bastian-bou/PFE-roule-ma-poule-sans-nid-de-poule/README.md

# PFE Roule ma poule

Pour avoir des informations, allez dans **docs**, pour le code source c'est **dev** et pour les schémas et la carte finale c'est **Hardware**
