bastian-bou/PFE-roule-ma-poule-sans-nid-de-poule/docs/README.md

# PFE Roule ma poule

Si tu es développeur, vas voir le dossier développement et lis le fichier mainteneur.pdf pour quelques informations supplémentaires sur la communication.

Si tu es électronicien, vas voir le dossier développement.

Si tu es mainteneur, vas voir le fichier mainteneur.pdf

Le projet s'est arrêté à un prototype donc un utilisateur n'existe pas encore. l'utilisateur se nomme mainteneur et des développements restent à faire.

Pour les datasheets des composants, c'est dans *datasheet*

Pour les commandes effectuées, c'est dans le dossier *Achats* (GPS, ESP32, capteurs, batteries ...)

Pour les résultats des tests du prototype, cest dans le dossier *datas*

## Sinon voici la description de tous les livrables : 

— **Cahier des charges** : Ce premier document détaille tous les besoins du client, de façon
simplifiée et synthétique. J’ai participé à l’élaboration de ce document. J’ai apporté
des idées et des pistes techniques. Je l’ai ensuite élaboré avec l’approbation de Nicolas
Monmarche.

— **Cahier de spécifications** : Ce document est fourni avant la réalisation technique.
Je décris ma prise de recul sur le projet, l’étude du cahier des charges, les détails
techniques du projet global, des capteurs à l’application mobile de l’utilisateur. Je
décris également les deux livrables attendus par le client. Je détail les différentes
technologies de capteur de vibration qui peuvent être utilisées, les blocs fonctionnels
nécessaires dans le boîtier, l’interaction entre le boîtier, l’application mobile et le
serveur. Il y a également des diagrammes présentant les programmes et un exemple
de design du boîtier avec des voyant, la prise de recharge ainsi que le bouton ON/OFF.

— **Cahier d’analyse** : Ce document décrit toutes les parties d’études théoriques et pra-
tiques sur le projet. Concernant la partie électronique, différents montages d’interfa-
çage des capteurs sont décrits ainsi que des études logicielles concernant les librairies
et la classe principale.

— **Documentation Conception logicielle** : Ce document présente tous les détails tech-
niques sur le logiciel que j’ai développé pendant mon PFE. Des diagrammes de classes,
des logigrammes, ainsi qu’une description détaillée du code source seront présents
dans ce document. Des détails concernant la suite du projet est également disponible
dans ce document. Vous trouverez également le lien GitLab pour accéder au code
source.

— **Documentation Conception matérielle** : Cette documentation décrit les différents
éléments électroniques choisis, toutes les caractéristiques qui les définissent et mon
choix de capteur pour la surveillance des failles dans la route.
