bastian-bou/PFE-roule-ma-poule-sans-nid-de-poule/docs/cahier de spécifications.pdf

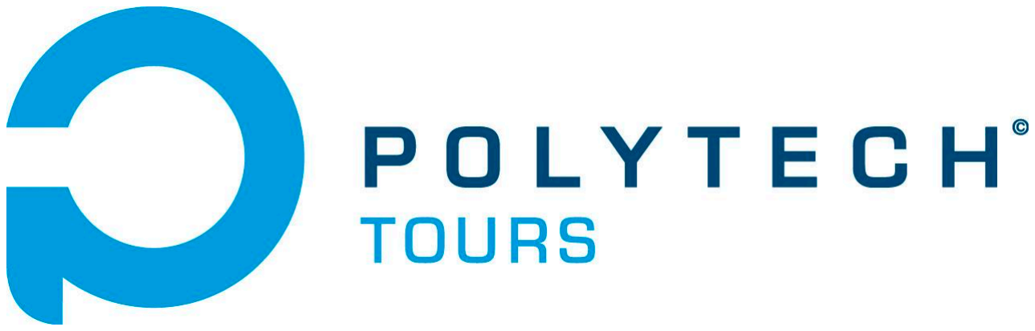
[picture p21: figure]

École Polytechnique de l’Université de Tours 64, Avenue Jean Portalis
37200 TOURS, FRANCE
Tél. +33 (0)2 47 36 14 14
www.polytech.univ-tours.fr

## Département Informatique

Cahier de spécification système & plan de développement

Projet : | Roule ma poule sans nid de poule
Emetteur : | B. Bouchardon | Coordonnées : EPU-DII
Date d’émission : | 11 novembre 2018

Validation

Nom | Date | Valide (O/N) | Commentaires

N MONMARCHE : 08/11/2018 ; OK ; pour 2018-2019 E NERON :

Historique des modifications

Version | Date | Description de la modification

00 : 07/11/2018 ; Version initiale non achevée, vérification par l’encadrant 01 : 11/11/2009 ; Version finale

# Table des matières

Cahier de spécification système | 5
Plan de développement | 19
Maquette CDS | III

# Cahier de spécification système

### 4 Maquette CDS

Introduction

## 1.1 Introduction

Ce document spécifie les points techniques et de gestion du projet "roule ma poule sans nid de poule" dirigé par Emmanuel Neron et Nicolas Monmarche. Bastian Bouchardon est le rédacteur de ce document.

## 1.2 Contexte de la réalisation

### 1.2.1 Contexte

Aujourd’hui, de nombreux moyens de déplacement existent pour faire les trajets quotidiens comme se rendre au travail, aller faire des courses, se déplacer à des événements culturels. Il y a les transports en commun comme le bus, le tramway ou le covoiturage et des transports personnels comme la voiture, le skateboard, les appareils électriques type mono wheel, hoverboard et le vélo. Ce dernier est de plus en plus utilisé pour les trajets quotidiens car il permet de garder une bonne forme physique, il est plus rapide que la voiture en ville, peu coûteux et facile d’entretien. Les cyclistes sont sensibles à l’état de la route, en effet, les routes abîmées, écorchées peuvent au mieux endommager, au pire les blesser. En France, d’après plusieurs études, les routes se dégradent, des motards sont décédés à cause de nids de poule, des accidents ont souvent lieu impliquant des cyclistes et des défauts de la route. C’est pour ces raisons que ce projet peut être apprécié des utilisateurs de vélo.

### 1.2.2 Objectifs

Il s’agit de réaliser un système embarqué sur tout type de vélo permettant de capter les vibrations dues à la route et d’envoyer ces informations avec une position GPS sur un serveur. Cela permettra de cartographier l’état des routes et de prévenir les usagers et collectivités. Ce système sera constitué, au final, d’une carte électronique contenant l’intelligence, le capteur, le récepteur GPS, l’alimentation et la communication sans fil. Au départ, il faudra tester et choisir une technologie de capteur qui correspondra à notre utilisation. Il faudra également créer un serveur pour recevoir ces informations.

### 1.2.3 Hypothèses

L’une des contraintes du système est la compatibilité avec tous les types de vélos. En effet, il y a les vélos de route ou de courses, sans suspensions, des roues et pneus très fins et très durs (entre 7 et 15 bars) donc un vélo très sensible aux vibrations et à l’opposé, les VTT (vélo tout-terrain), avec de pneus larges, des fourches avec suspensions non sensibles aux vibrations. Il faut que ce capteur puisse fonctionner sur un vélo de route comme sur un VTT. si le capteur ne peut pas fonctionner sur le cadre, alors il faudra trouver une autre position comme le moyeu d’une des roues mais si ce choix est validé, alors il faudra supprimer la connexion entre ce capteur et une éventuelle dynamo.

Maquette CDS | 5

TABLE DES MATIÈRES

## 1.3 Description générale

### 1.3.1 Environnement du projet

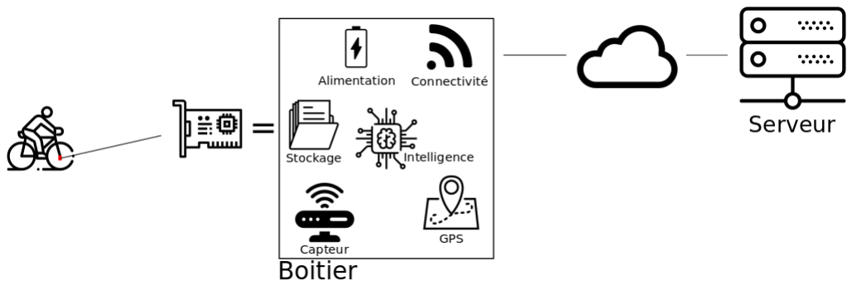
[picture p22: figure]

Figure 1.1 – Environnement du projet

Le projet sera sous la forme d’un boitier placé sur un vélo, Il contiendra une carte électronique compre-nant :
— Un système de communication sans fil type Wifi, bluetooth ou sur un réseau LPWAN. ¹
type LoRa,
Sigfox.
— Un capteur de vibration qui sera défini lors du premier livrable. il pourra être de type piezzo-électrique, résistif capacitif, . . .
— Un système de positionnement tel que le GPS permettant de connaître la position du véhicule.
— Une intelligence permettant de récupérer une valeur correspondant à la vibration, l’interpréter, récupérer la position GPS en interprétant les trames, mettre en forme ces données et envoyer ces informations sur le serveur.
— Un stockage des données si il n’y a pas de connexion permanente avec le serveur.
— Un module d’alimentation électrique avec une source d’énergie : une batterie et un système de conversion pour correspondre aux différents modules ci-dessus.
Le système sera le moins énergivore possible, il devra activer les systèmes de communication et de réception de la position seulement lorsque cela est nécessaire. Il pourra être connecté à un serveur externe, comme celui d’une société. Il y aura également une interaction entre le client et le boitier par le biais d’une application ou d’un site internet lui permettant de visualiser ses informations comme ses parcours, son profil, configurer le boitier en matière d’identité (anonymer les informations le concernant ou non, la récurrence d’envoi de ces informations sur le serveur, . . .).

### 1.3.2 Caractéristiques des utilisateurs

Le capteur connecté sera utilisé par tous types de cyclistes. Des cyclistes quotidiens, sportifs, cyclistes occasionnels, . . .Le système devra donc être le plus facile d’accès possible, pour tous les âges et toutes les utilisations. Éviter au maximum les paramétrages du système et se poser la question quant à la nécessité de posséder un smartphone sur soi ou non.

1. Low Power Wide Area Network

### 6 Maquette CDS

Description générale

### 1.3.3 Fonctionnalités et structure générale du système

Voici un diagramme des principaux cas d’utilisations du système, du point de vue de l’utilisateur. Ce système est la plupart du temps autonome, l’utilisateur joue un rôle mineur dans le fonctionnement. On y retrouve les quatre principales fonctionnalités :

— Le traitement des données provenant du capteur de vibration et du GPS.
— La configuration du système par l’utilisateur. La récurrence d ?envoi des données, la connexion, . . . — La connexion du système au serveur.
— La visualisation des parcours et de l’état de la route.

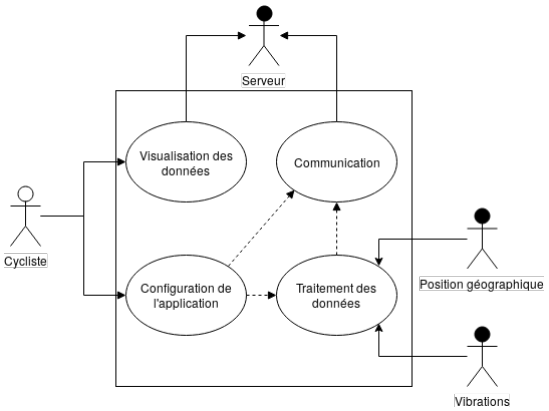
[picture p23: figure]

Figure 1.2 – diagramme de cas d’utilisation général

Voici une description des cas d’utilisation :

Cas d’utilisation | Traitement par le système
Description | Réception et traitement des informations du capteur et du GPS puis mise en forme des données à envoyer
Acteurs | GPS et capteur de vibration
Pré-conditions | Avoir encore assez de stockage disponible si nous n’avons pas accès au serveur
Post-conditions | Données mises en forme
Flux d’activité | 1 - Le système récupère la vibration 2 - Il interprète ces vibrations 3 - Il récupère la position GPS 4 - Mise en forme des données GPS et des vibrations
Maquette CDS | 7

TABLE DES MATIÈRES

Cas d’utilisation | Communication
Description | Envoi des données sur le serveur
Acteur | Serveur
Pré-conditions | Données correctement mises en forme et accès au serveur
Post-conditions | Bonne réception des données par le serveur
Flux d’activité | 1 - Réception des données par le système de traitement 2 - Connexion au serveur 3 - Envoi des données au serveur 4 - Déconnexion du serveur
Cas d’utilisation | Visualisation des données (parcours)
Description | Visualisation des données utilisateur stockées sur le serveur par le biais d’une application
Acteur | Utilisateur, Serveur
Pré-conditions | Accès au serveur
Post-conditions | Affichage des informations
Flux d’activité | 1 - Demande des informations concernant l’utilisateur suivant des para-mètres 2 - Réception de ces informations 3 - Affichage des informations sur l’application
Cas d’utilisation | Configuration du système
Description | Configuration du système par l’utilisateur sans fil
Acteur | Utilisateur
Pré-conditions | Utilisateur connecté au système
Post-conditions | Application de la configuration par le système
Flux d’activité | 1 - Modification de certains paramètres 2 - Enregistrement des paramètres

### 1.3.4 Contraintes de développement, d’exploitation et de maintenance

Contraintes de développement

Comme le système entier est à développer, il n’y a pas de contraintes entre le matériel et le logiciel. Par contre le système doit avoir la meilleure autonomie possible. Cela passe par le choix des composants, le choix des systèmes de communication, la programmation embarquée.
Il faut également que le serveur, le système embarqué et le téléphone du cycliste puissent fonctionner en écosystème. Le serveur doit pouvoir enregistrer les informations provenant des vélos et puisse envoyer les informations demandées par les cyclistes. Il faudra également développer une application pour les cyclistes, pour qu’ils puissent configurer le système embarqué sur leur vélo et qu’ils puissent visualiser leurs informations. Cette application peut être développée sur une cible type Android ou iOS. Un site internet n’est pas pertinent car l’application permettra au système embarqué d’utiliser la connexion au réseau mobile du smartphone pour envoyer ses informations au serveur en passant par une connexion bluetooth si l’utilisateur en donne la permission.
Ce développement logiciel est secondaire, la priorité est sur le choix du capteur et la réalisation du système embarqué.
Il va falloir également mettre en place un simulateur pour tester et choisir un capteur de vibration répon-dant à notre besoin. Ce simulateur sera une route étalon, un ou plusieur type de vélo étalons pour pouvoir mettre en évidence les différences et comparer les différentes technologies de capteurs.
Je n’ai pas d’algorithmes imposé, cependant il faut que mon algorithme de détection des nids-de-poule

### 8 Maquette CDS

Description des interfaces externes du logiciel

puisse s’adapter au type de route, aux vibrations fréquentes, . . .Je n’ai pas non plus de bibliothèques de programmes imposées ou de protocole de communication particulier.
Le projet, c’est-à-dire le choix du capteur, le système embarqué terminé et un prototype de serveur doit être terminé à la date de fin du projet de fin d’études.

Contraintes d’exploitation

L’envoi des parcours des utilisateurs sur le serveur demandera une réflexion particulière, sur le format des trames, les informations présentes ainsi que le chiffrement de ces données ou non. En effet, cela peut représenter un problème si il y a des données personnelles présentes dans les trames. Par contre si il n’y a pas de moyen pour un éventuel hacker d’identifier les informations transmises par le système embarqué, un chiffrage des informations n’est éventuellement pas nécessaire.

## 1.4 Description des interfaces externes du logiciel

### 1.4.1 Interfaces matériel/logiciel

Le système nécessitera une connexion directe ou indirecte à internet pour transmettre des informations à un serveur.
Directe par une connexion LPWAN ou par une connexion Wi-Fi permettant avec un minimum de configuration au système d’envoyer ses informations.
Indirect par le biais du bluetooth, le système envoie les informations au téléphone qui se charge de les envoyer sur le serveur par le biais de l’application.
Le système (le boitier sur le vélo et l’application sur téléphone) communiquera en TCP/IP avec le serveur sur internet.
Concernant le boitier, le GPS sera connecté en UART sur l’élément programmable du système. En effet plusieurs modules GPS dans le commerce sont commandés par UART, c’est un système de communication très répandu et il est très fiable.

### 1.4.2 Interfaces homme/machine

Application : L’interface n’est pas encore définie mais il faudra au moins 3 pages :
— Une page de connexion permettant de connecter le boitier au téléphone. En arrière-plan, l’application activerait le bluetooth.
— Une page de visualisation des parcours avec une carte, les parcours effectuaient ainsi que l’état des routes.
— Une page de configuration permettant au cycliste de configurer son boitier, son nom d’utilisateur, . . .
Une interface très simple, épurée avec de simples boutons type sliders à l’image du boitier.

Boitier : Le boitier, suivant sa position sur le vélo, ne sera pas forcément accessible. Les interactions avec l’utilisateur doivent être minimes. J’ai donc choisi de n’avoir qu’un seul bouton sur le boitier, de préférence sensitif pour que le boitier reste étanche (interrupteur sensitif derrière une paroie du boitier) permettant d’appairer le dispositif au téléphone du cycliste et de servir d’interrupteur marche / arrêt suivant la longueur ou le nombre d’appui. Cette fonctionnalité peut également être implémentée par un simple interrupteur mécanique placé sur le flanc du boitier. Ajoutez à cela quelques voyants indiquant le niveau de batterie ou l’état du boitier permettant de savoir dans quel état est le système (connecté, en phase d’appairage, problème de connexion, envoie de données, . . .) et d’avoir un diagnostic rapide si le boitier est défaillant. Il y aura également un connecteur placé sur le côté du boitier permettant de recharger ce dernier. Voici une maquette de l’interface ci-dessous :

Maquette CDS | 9

TABLE DES MATIÈRES

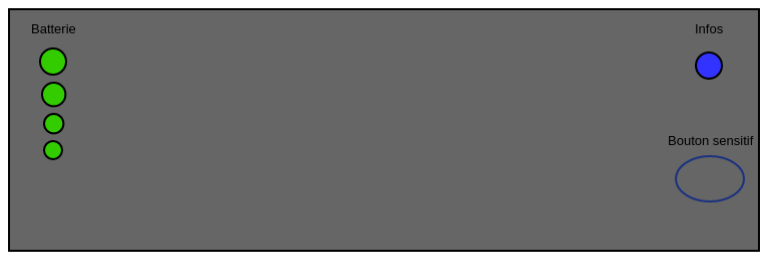
[picture p24: figure]

Figure 1.3 – design de l’IHM sur le boitier

### 1.4.3 Interfaces logiciel/logiciel

Les interfaces entre boîtier/serveur et serveur/application seront les mêmes. Les données seront sous la forme de trames binaires simples permettant d’avoir de petite quantité de données à échanger et donc des envoient et réceptions rapides sur le serveur. En effet, si la communication est difficile entre le boitier et le serveur, cela permettra de s’affranchir d’un format type JSON qui rajoute des octets dont on peut s’affranchir dans notre cas. Les accès au serveur par le boîtier peuvent être un envoi après chaque parcours ou un envoi après plusieurs parcours. Des envoie réguliers pendant un parcours ne sont pas nécessaires car nous ne pouvons pas accéder à ces données pendant notre trajet.

## 1.5 Architecture générale du système

Dans cette partie on retrouve les principaux composants/éléments du système ainsi que leurs relations.


Figure 1.4 – Diagramme de blocs fonctionnels global

### 10 Maquette CDS

Architecture générale du système

L’utilisateur par le biais de son téléphone, fera la passerelle entre le boitier et le serveur et lui permettra d’interagir avec le boitier en le configurant et en visualisant les informations concernant son/ses parcour(s). On pourra également imaginer que le boitier puisse envoyer les informations directement au serveur sans passer par le téléphone du cycliste (route discontinue).

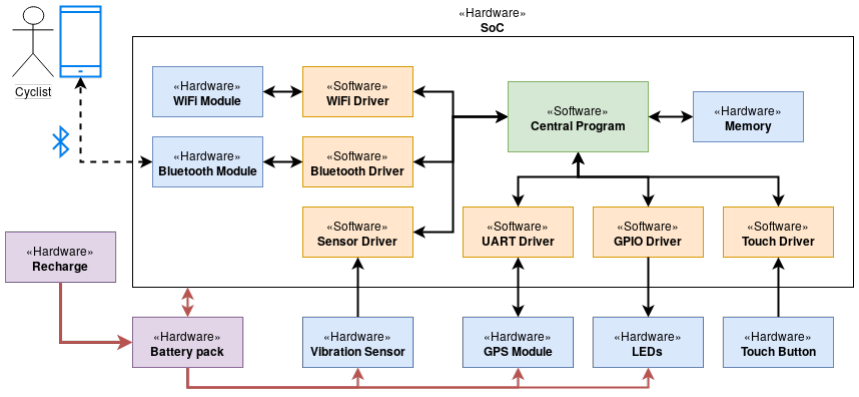
[picture p25: figure]

Figure 1.5 – Diagramme de blocs fonctionnels - Boitier

Le boitier sera constitué d’une intelligence, celle-ci aura des modules de communication bluetooth et Wi-Fi. Elle commandera les LEDs de visualisation pour l’utilisateur, elle recevra les informations du GPS, du capteur de vibration et du bouton sensitif. C’est le coeur du système. En plus de cela, elle recevra une valeur analogique image de la tension de la batterie permettant de signaler au cycliste le niveau de batterie restant. Il y aura également une mémoire présente dans le système pour enregistrer les données d’état de la route suivant les paramètres de l’utilisateur et de la connexion disponible.

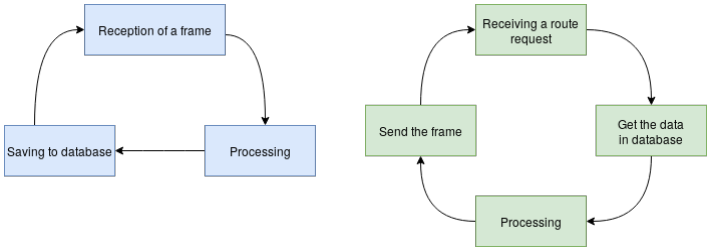
[picture p26: figure]

Figure 1.6 – Diagramme de blocs fonctionnels - Serveur

Sur la partie serveur, Deux modes coexistent, le mode réception de données où un boitier/smartphone envoie des données au serveur sous forme de trames binaires, le serveur traite ces données et les enregistre dans une base de données. Deux processus seront exécutés sur le serveur, un processus recevra les informations et les transformera pour les enregistrer dans la base de données qui sera le second processus.
Le second mode permettra une communication entre un client (smartphone) et le serveur. Lors d’une
Maquette CDS | 11

TABLE DES MATIÈRES

demande d’un téléphone, le serveur récupérera les informations correspondant à cette demande dans la base de données et un second processus transformera ces données en trames binaires pour les envoyer à l’application qui les mettra en forme pour être visualisées par l’utilisateur.
Un dernier mode permettra à l’utilisateur d’envoyer ses informations le concernant permettant ainsi qu’il puisse voir ses trajets personnels.

## 1.6 Description des fonctionnalités

Dans cette partie sont développées les fonctionnalités du système. Nous rentrons plus en détail dans les fonctionnalités de la partie 1.3.3. Des détails sont apportés aux fonctionnalités suivantes :
— Traitement des données (boitier)
— Configuration du système (boitier)
— Visualisation des informations
— Communication avec le serveur (depuis le boitier)
Et d’autres fonctionnalités correspondant aux diagrammes des blocs fonctionnels 1.5 : — Création d’un utilisateur dans le serveur
— Ajout d’un parcours sur le serveur
— Envoi des parcours d’un utilisateur depuis le serveur
— Gestion de l’alimentation et de l’IHM boitier

### 1.6.1 Définition de la fonction Traitement de données (boitier)

Identification de la fonction Traitement de données

Présenter la fonction :
— Traitement des données ;
— Cette fonction permet de récupérer les vibrations et la position GPS par intervalles réguliers et traite ces données ;
— Cette fonction est primordiale pour les livrables du projet. Une partie de cette fonction (acquisition) sera également mise en place lors des phases de tests du capteur de vibration nécessaire au premier livrable.

Description de la fonction Traitement de données

— Cette fonction est connectée au capteur de vibration et au capteur GPS. Le capteur de vibration est à choisir pour le premier livrable donc on ne connaît pas encore quel type d’entrée nous aurons mais elle sera de type, ADC, GPIO, I²C, SPI, . . .Pour le GPS, l’entrée sera une entrée série UART. La sortie de cette fonction sera connectée à la fonction communication ;
— Cette fonction interagie avec le capteur de vibration et le GPS. Elle agira également avec la mémoire du microcontrôleur ou SoC choisi ;

### 1.6.2 Définition de la fonction communication avec le serveur (depuis le boitier)

Identification de la fonction communication avec le serveur

Présenter la fonction :
— Communication avec le serveur ;
— Cette fonction envoie les données au serveur par le biais du téléphone du cycliste ;
— Cette fonctionnalité est primordiale pour tester l’envoie au serveur et avoir un stockage sur le serveur permettant de qualifier le système entier. Cette fonction fait partie du système de base.

### 12 Maquette CDS

Description des fonctionnalités

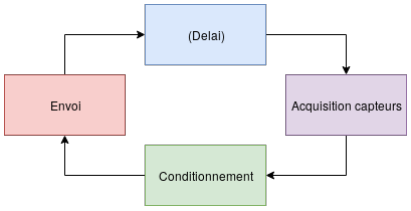
[picture p27: figure]

Figure 1.7 – Fonction Traitement des données

Description de la fonction communication avec le serveur

— Les entrées proviennent de la fonction Traitement des données ci-dessus et la fonction gestion de l’alimentation et de l’IHM boitier permettant d’appairer un téléphone avec le boitier. Cette fonction possède deux sorties, l’une sur le module Bluetooth et Wi-Fi dans un second temps (facultatif). La seconde est une mémoire permettant de stocker les données si il n’y a pas de connexion ou si l’utilisateur à choisit de n’envoyer les données qu’à chaque fin de trajet ou autres ;
— Cette fonction intéragie avec la mémoire du système et les modules Wi-Fi/bluetooth ;
— Si le smartphone n’a pas d’accès au réseau, le boitier enregistrera les données dans sa mémoire pour les envoyer lorsque le réseau sera de nouveau disponible.

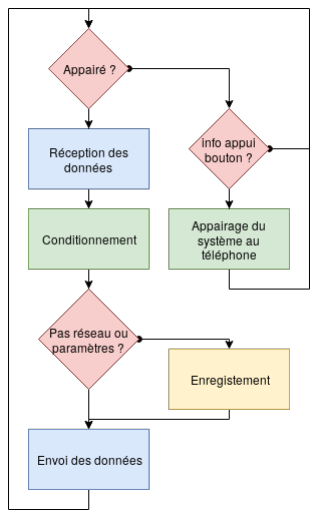
[picture p28: figure]

Figure 1.8 – Fonction Communication avec le serveur

Maquette CDS | 13

TABLE DES MATIÈRES

### 1.6.3 Définition de la fonction visualisation des informations

Identification de la fonction visualisation des informations

Présenter la fonction :
— Visualisation des informations ;
— Cette fonction permet à l’utilisateur de visualiser ses parcours sur l’application de son téléphone ; — Cette fonctionnalité est secondaire car il faut d’abord capter et enregistrer les données sur un serveur avant de pouvoir les visualiser.

Description de la fonction visualisation des informations

— En entrée nous avons le serveur permettant de récupérer les informations stockées à propos de l’utilisateur et en sortie L’affichage de l’application sur le téléphone du cycliste ;
— Cette fonction interagie avec le serveur de stockage et le téléphone de l’utilisateur ;

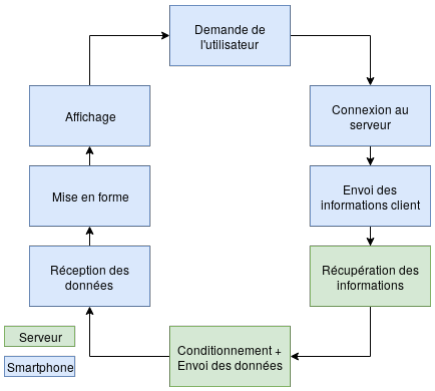
[picture p29: figure]

Figure 1.9 – Fonction visualisation des informations

### 14 Maquette CDS

Description des fonctionnalités

### 1.6.4 Définition de la fonction configuration du système

Identification de la fonction configuration du système

Présenter la fonction :
— configuration du système ;
— Elle permet à l’utilisateur de configurer le boitier et son profil dans le serveur. Cela lui permet de configurer la récurrence d’envoi des données, la connexion, et de récupérer les parcours de l’utilisateur sur le serveur ;
— Cette fonction est secondaire, l’utilisateur peut utiliser le boitier avec des valeurs par défaut avant que cette fonctionnalité soit implémentée et les données peuvent être enregistrées sur le serveur sans identification.

Description de la fonction configuration du système

— Le smartphone et les choix de l’utilisateur sont les entrées de la fonction. En sortie nous avons l’intelligence du boitier et une table d’une base de données du serveur pour l’identification de l’utilisateur ;
— Cette fonction interagie avec l’utilisateur, le boitier et le serveur ;

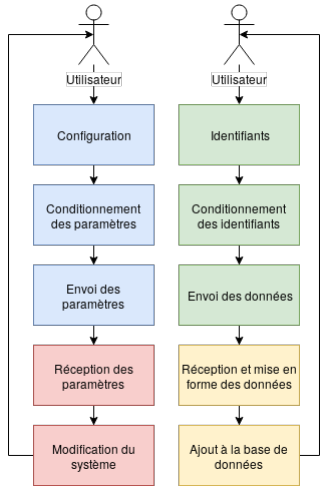
[picture p30: figure]

Figure 1.10 – Fonction configuration des informations

Les couleurs bleues et vertes représentent la partie téléphone, la partie rouge représente le boitier et enfin la partie jaune représente le serveur.

Maquette CDS | 15

TABLE DES MATIÈRES

### 1.6.5 Définition de la fonction gestion de l’alimentation et de l’IHM boitier

Identification de la fonction gestion de l’alimentation et de l’IHM boitier

Présenter la fonction :
— gestion de l’alimentation et de l’IHM boitier ;
— Cette dernière fonction permet de contrôler l’alimentation du boitier, informer et alerter l’utilisateur du niveau de batterie, de l’état actuel du boitier et enfin appairer le boitier au téléphone ;
— cette fonctionnalité est secondaire dans le projet.

Description de la fonction gestion de l’alimentation et de l’IHM boitier

— Les entrées de cette fonction sont la tension image du niveau de batterie et la touche sensitive. En sortie nous avons les LEDs de visualisations permettant d’indiquer le niveau de batterie et l’état du système et enfin la fonction communication avec le serveur permettant d’appairer le boitier avec un téléphone en bluetooth ;
— Cette fonction interagie avec les LEDs de visualisation et l’interrupteur ;
— Le niveau de batterie n’a pas besoin d’être vérifier et afficher en permanence. Cela peut être fait seulement lors du début du parcours par le cycliste (lorsqu’il démarre le système par exemple). Par contre, la valeur de l’interrupteur a besoin d’être scruté en permanence. Pour la LED de visualisation d’état, elle doit être allumée lors d’événements comme un envoi de données, une erreur de connexion, un appairage en cours, . . .

### 16 Maquette CDS

Conditions de fonctionnement

## 1.7 Conditions de fonctionnement

### 1.7.1 Performances

Le système doit fonctionner tout le long des trajets, à scruter l’état de la route, la fonction de traitement des données doit fonctionner en permanence. Nous n’avons pas de problème temps réel sur le projet mais ce traitement doit être prioritaire sur le logiciel embarqué dans le boitier. Il doit également scruter l’interrupteur sensitif mais seulement lorsque le boitier n’est pas appairé à un téléphone, dans ce cas le système ne fonctionne pas (aucun parcours possible).
Sur la communication, le télépone ou le serveur peuvent être inaccessibles durant un ou plusieurs parcours suivant la taille de la mémoire embarqué et le format des trames envoyées, leur taille. Côté serveur, il doit être toujours disponible, aucune indisponibilité n’est acceptée.

### 1.7.2 Capacités

Il n’y a pas de capacité maximum sur le système complet identifié. Il y aura une capacité maximum d’utilisateurs et de données stockée sur le serveur et cela correspondra à la capacité du serveur (la taille de stockage). Également un nombre maximum client se connectant au serveur simultanément.
Il y aura également un nombre maximum de parcours pouvant être stocké sur la mémoire du boitier avant de faire une mise à jour sur le serveur mais tout cela n’est pas encore fixé.

### 1.7.3 Modes de fonctionnement

Pour démarrer le système il faudra allumer le boitier à l’aide d’un long appui sur le bouton sensitif ou bien un interrupteur marche / arrêt placé sur le boitier. ensuite le système commencera à enregistrer les vibrations. Un autre type d’appui sur le bouton permettra d’appairer le boitier à un téléphone.

Maquette CDS | 17

# Plan de développement

### 18 Maquette CDS

Découpage du projet en tâches

## 2.1 Découpage du projet en tâches

Voici la liste des tâches du projet Roule ma poule sans nid de poule provenant du gantt prévisionnel :

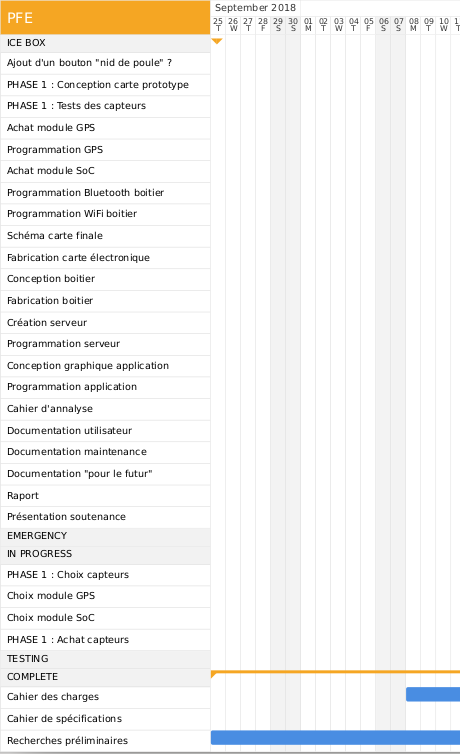
[picture p31: figure]

Figure 2.11 – Liste des tâches du projet

Les paragraphes suivants présentent les grandes tâches listées.
Les durées sont données en semaine / homme, nous considérons une semaine par 1h/jour pendant 5 jours + 3 heures/jour pendant 2 jours (week-end), soit un total de 11 heures par semaine.
Maquette CDS | 19

TABLE DES MATIÈRES

### 2.1.1 Tâche Cahier des charges

Description de la tâche

Il s’agit d’écrire ce document.

Livrables

À la fin de cette tâche, il s’agit de rendre ce document pour contrôle.

Estimation de charge

Cette tâche est estimée à 3 semaines.

Contraintes temporelles

La tâche doit être terminée avant le 11 / 11 / 2018 à 23 h.

### 20 Maquette CDS

Découpage du projet en tâches

### 2.1.2 Tâche Cahier d’analyse

Description de la tâche

Il s’agit d’écrire le cahier d’analyse permettant de supprimer toutes les incertitudes techniques du projet.

Livrables

Un cahier d’analyse sera rendu.

Estimation de charge

Cette tâche sera réalisée pendant une bonne partie de la conception du système, elle s’étend donc sur 6 semaines mais avec très peu d’heures par semaine.

Contraintes temporelles

Cette tâche doit être réalisée avant le 13 janvier 2019.

Maquette CDS | 21

TABLE DES MATIÈRES

### 2.1.3 Tâche PHASE 1

Description de la tâche

Cette tâche constitue le premier livrable. Elle inclut le choix et l’achat de plusieurs capteurs de vibration différents, la conception d’un système prototype de test et les tests de ces capteurs pour ne choisir que celui qui correspond à notre besoin.

Cycle de vie

Cette tâche possédera une longue phase de test. Elle aboutira sur le choix d’un capteur avec les raisons de ce choix.

Livrables

Un rapport sera apporté aux encadrants du projet.

Estimation de charge

L’estimation de cette tâche principale est de 6 semaines.

### 22 Maquette CDS

Découpage du projet en tâches

### 2.1.4 Tâche Études

Description de la tâche

Cette tâche regroupe toutes les études techniques concernant le fonctionnement du système, les choix techniques, . . .excepté la Phase 1 décrite précédemment.

Livrables

Les éléments choisis apparaîtront dans le cahier d’analyse.

Estimation de charge

Nous avons estimé cette tâche à 4 semaines en sachant qu’elle est pratiquement terminée.

Maquette CDS | 23

TABLE DES MATIÈRES

### 2.1.5 Tâche Conceptions

Description de la tâche

Elle consiste à concevoir la carte électronique finale, le boitier, la création du serveur et les délais de livraison et de fabrication.

Livrables

Il n’y aura pas de livraison à proprement parlé sur cette tâche.

Estimation de charge

Nous avons estimé ce regroupement de tâches à 7 semaines.

Contraintes temporelles

Il y aura des contraintes temporelles sur l’achat et la livraison de la carte électronique pour ne pas engendrer des retards sur les autres tâches.

### 24 Maquette CDS

Découpage du projet en tâches

### 2.1.6 Tâche Programmations

Description de la tâche

Cette tâches regroupe la programmation du boitier (système embarqué), de l’application téléphone et du serveur.

Cycle de vie

Cette tâche, spécifiquement sur la programmation orientée objet sera découpée en sprint de 1 semaine. Des phases de tests pour ces programmes seront également mises en place tout au long de la réalisation.

Estimation de charge

Cette tâche est estimée à 10 semaines pour tous les programmes cités ci-dessus.

Maquette CDS | 25

TABLE DES MATIÈRES

### 2.1.7 Tâche Documentations

Description de la tâche

Cette tâche regroupe toute la documentation finale : les manuels utilisateur / maintenance, le rapport, la soutenance et les propositions pour la suite du projet.

Livrables

Les livrables seront tous les documents et la présentation du projet en soutenance.

Estimation de charge

Cette tâche est estimée à 5 semaines en fin de projet.

Contraintes temporelles

Ces documents font partie des livrables donc ont de fortes contraintes temporelles.

### 26 Maquette CDS

Planning

## 2.2 Planning

PFE

ICE BOX

Ajout d'un bouton "nid de poule" ?

PHASE 1 : Conception carte prototype

test capteurs PHASE 1 : Tests des capteurs

Achat module GPS

Programmation GPS

Achat module SoC

Programmation Bluetooth boitier

Programmation WiFi boitier

Schéma carte finale

Fabrication carte électronique

Conception boitier

Fabrication boitier

Création serveur

Programmation serveur

Conception graphique application

Programmation application

Cahier d'annalyse

Documentation utilisateur

Documentation maintenance

Documentation "pour le futur"

Raport

Présentation soutenance

EMERGENCY

IN PROGRESS

PHASE 1 : Choix capteurs

Choix module GPS

Choix module SoC

PHASE 1 : Achat capteurs

TESTING
COMPLETE

Cahier des charges

Cahier de spécifications

Recherches préliminaires

September 2018

2
T
5 26
W

2
T
7 2

F
8 29

S

30
S

October 2018

01
M

0
T
2 03
W

0
T
4 0

F
5 06

S

07
S

08
M

0
T
9 10
W

1
T
1 1

F
2 13

S

14
S

15
M

1
T
6 17
W

1
T
8 1

F
9 20

S

21
S

22
M

2
T
3 24
W

2
T
5 2

F
6 27

S

28
S

29
M

3
T
0 31
W

November 2018

0
T
1 0

F
2 03

S

04
S

05
M

0
T
6 07
W

0
T
8 0

F
9 10

S

11
S

12
M

1
T
3 14

W 15

1
F
6 17

S

18
S

19
M

2
T
0 21
W

2
T
2 2

F
3 24

S

25
S

26
M

2
T
7 28
W

2
T
9 3

F
0

December 2018

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
4 05
W

0
T
6 0

F
7 08

S

09
S

10
M

1
T
1 12
W

1
T
3 1

F
4 15

S

16
S

17
M

1
T
8 19
W

2
T
0 2

F
1 22

S

23
S

24
M

2
T
5 26
W

2
T
7 2

F
8 29

S

30
S

31
M

January 2019

0
T
1 02
W

0
T
3 0

F
4 05

S

06
S

07
M

0
T
8 09
W

1
T
0 1

F
1 12

S

13
S

14
M

1
T
5 16
W

1
T
7 1

F
8 19

S

20
S

21
M

2
T
2 23
W

2
T
4 2

F
5 26

S

27
S

28
M

2
T
9 30
W

3
T
1

February 2019

0
F
1 02

S

03
S

04
M

0
T
5 06
W

0
T
7 0

F
8 09

S

10
S
Figure 2.12 – Gantt prévisionnel
Maquette CDS | 27
