bastian-bou/PFE-roule-ma-poule-sans-nid-de-poule/docs/Achats/Bon de Commande TVA 20 PFE.xlsx

Sheet: Bon à remplir
Fournisseur | Nom | Farnell, Mouser
 | Adresse
Etudiants | Promotion | DII5A |  | Encadrant | Nom | Emmanuel Neron
 | Noms | Bouchardon | Bastian |  |  | Nicolas Monmarche
Projet | Type
 | Identifiant (titre ou Id) |  | PFE Roule ma poule sans nid de poule
N° nom. | Références | Devis | Désignation produits, prestations |  | N°inventaire | Montant unitaire H.T. | Quantité | Montant H.T. | Montant T.V.A. | Montant T.T.C.
 | 2771960 | Farnell | Capteur film piézo électrique |  |  | 8.15 € | 2 | 16.30 € | 3.26 € | 19.56 €
 | 2748877 | Farnell | Capteur type centilever 260pC/g |  |  | 4.34 € | 2 | 8.68 € | 1.74 € | 10.42 €
 | 2748879 | Farnell | Capteur type centilever 16pC/g |  |  | 4.29 € | 2 | 8.58 € | 1.72 € | 10.30 €
 | 2061873 | Farnell | Module Accéléromètre 3 axes |  |  | 13.14 € | 2 | 26.28 € | 5.26 € | 31.54 €
 | 356-ESP32-DEVKITC (https://www.mouser.fr/ProductDetail/Espressif-Systems/ESP32-DevKitC) | Mouser | Module ESP32 Espressif systems |  |  | 8.73 € | 2 | 17.46 € | 3.49 € | 20.95 €
 | 713-101020586 (https://www.mouser.fr/ProductDetail/Seeed-Studio/101020586) | Mouser | Module capteur vibration SW420 |  |  | 2.18 € | 2 | 4.36 € | 0.87 € | 5.23 €
 | 2281693 (https://fr.farnell.com/maestro-wireless-solutions/a2035h/module-gps-w-ant-sirf-iv/dp/2281693?st=GPS) | Farnell | GPS |  |  | 20.03 € | 1 | 20.03 € | 4.01 € | 24.04 €
 |  |  |  |  |  |  |  | 0.00 € | 0.00 € | 0.00 €
 |  |  |  |  |  |  |  | 0.00 € | 0.00 € | 0.00 €
 |  |  |  |  |  |  |  | 0.00 € | 0.00 € | 0.00 €
 |  |  |  |  |  |  |  | 0.00 € | 0.00 € | 0.00 €
Total de la commande |  |  |  |  |  |  |  | 101.69 € | 20.34 € | 122.03 €
Date | 2018-11-16

Sheet: Fournisseurs
Farnell
RS
Selectronic
Digikey
Gotronic
Lextronic
Conrad.pro
Amazon | A éviter
LDLC.Pro
Fnac.com
Leroy Merlin
