bastian-bou/PFE-roule-ma-poule-sans-nid-de-poule/docs/Achats/Bon de Commande TVA 20 PFE1.xlsx

Sheet: Bon à remplir
Fournisseur | Nom | RS
 | Adresse
Etudiants | Promotion | DII5A |  | Encadrant | Nom | Emmanuel Neron
 | Noms | Bouchardon | Bastian |  |  | Nicolas Monmarche
Projet | Type
 | Identifiant (titre ou Id) |  | PFE Roule ma poule sans nid de poule
N° nom. | Références | Devis | Désignation produits, prestations |  | N°inventaire | Montant unitaire H.T. | Quantité | Montant H.T. | Montant T.V.A. | Montant T.T.C.
 | 880-1551 (https://fr.rs-online.com/web/p/batteries-taille-speciale/8801551/) |  | Batterie 18650 Lithium-ion 2700mAh |  |  | 9.73 € | 4 | 38.92 € | 7.78 € | 46.70 €
 |  |  |  |  |  |  |  | 0.00 € | 0.00 € | 0.00 €
 |  |  |  |  |  |  |  | 0.00 € | 0.00 € | 0.00 €
 |  |  |  |  |  |  |  | 0.00 € | 0.00 € | 0.00 €
 |  |  |  |  |  |  |  | 0.00 € | 0.00 € | 0.00 €
 |  |  |  |  |  |  |  | 0.00 € | 0.00 € | 0.00 €
 |  |  |  |  |  |  |  | 0.00 € | 0.00 € | 0.00 €
 |  |  |  |  |  |  |  | 0.00 € | 0.00 € | 0.00 €
 |  |  |  |  |  |  |  | 0.00 € | 0.00 € | 0.00 €
 |  |  |  |  |  |  |  | 0.00 € | 0.00 € | 0.00 €
 |  |  |  |  |  |  |  | 0.00 € | 0.00 € | 0.00 €
Total de la commande |  |  |  |  |  |  |  | 38.92 € | 7.78 € | 46.70 €
Date | 2018-11-22

Sheet: Fournisseurs
Farnell
RS
Selectronic
Digikey
Gotronic
Lextronic
Conrad.pro
Amazon | A éviter
LDLC.Pro
Fnac.com
Leroy Merlin
