bastian-bou/PFE-roule-ma-poule-sans-nid-de-poule/docs/datas/test3_05-02-2019_GpsPoly_Home.csv

LATITUDE | LONGITUDE
47.364948 | 0.685128
47.364948 | 0.685128
47.364948 | 0.685128
47.364948 | 0.685128
47.364948 | 0.685128
47.364948 | 0.685128
47.364948 | 0.685128
47.364948 | 0.685128
47.364948 | 0.685128
47.364948 | 0.685128
47.364948 | 0.685128
47.364948 | 0.685128
47.364948 | 0.685128
47.364948 | 0.685128
47.364948 | 0.685128
47.364948 | 0.685128
47.364948 | 0.685128
47.364948 | 0.685128
47.364948 | 0.685128
47.364948 | 0.685128
47.364948 | 0.685128
47.364948 | 0.685128
47.364948 | 0.685128
47.364948 | 0.685128
47.364948 | 0.685128
47.364948 | 0.685128
47.364948 | 0.685128
47.364948 | 0.685128
47.364948 | 0.685128
47.364948 | 0.685128
47.364948 | 0.685128
47.364948 | 0.685128
47.364948 | 0.685128
47.364948 | 0.685128
47.364948 | 0.685128
47.364948 | 0.685128
47.364948 | 0.685128
47.364948 | 0.685128
47.364948 | 0.685128
47.364948 | 0.685128
47.364948 | 0.685128
47.364948 | 0.685128
47.364948 | 0.685128
47.364948 | 0.685128
47.364948 | 0.685128
47.364948 | 0.685128
47.364948 | 0.685128
47.364948 | 0.685128
47.364948 | 0.685128
47.364948 | 0.685128
47.364948 | 0.685128
47.364948 | 0.685128
47.364948 | 0.685128
47.364948 | 0.685128
47.372940 | 0.689217
47.372982 | 0.689513
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
