bastian-bou/PFE-roule-ma-poule-sans-nid-de-poule/docs/datas/test3_06-02-2019_GpsHome_Poly.csv

LATITUDE | LONGITUDE
47.397820 | 0.702017
47.397640 | 0.702043
47.397274 | 0.702258
47.397778 | 0.701610
47.396763 | 0.700648
47.396706 | 0.700403
47.396648 | 0.700210
47.396687 | 0.700027
47.396786 | 0.699737
47.396793 | 0.699513
47.396786 | 0.699305
47.396786 | 0.699182
47.396809 | 0.699255
47.396801 | 0.699347
47.396801 | 0.699347
47.396801 | 0.699348
47.396801 | 0.699350
47.396801 | 0.699348
47.396816 | 0.699370
47.396835 | 0.699375
47.396835 | 0.699392
47.396809 | 0.699400
47.396801 | 0.699397
47.396801 | 0.699395
47.396809 | 0.699405
47.396801 | 0.699468
47.396793 | 0.699458
47.396770 | 0.699408
47.396664 | 0.699345
47.396542 | 0.699392
47.396412 | 0.699487
47.396095 | 0.699520
47.395939 | 0.699522
47.395565 | 0.699420
47.395298 | 0.699262
47.395084 | 0.699035
47.394920 | 0.698775
47.394791 | 0.698525
47.394619 | 0.698157
47.394516 | 0.697863
47.394466 | 0.697645
47.394321 | 0.697297
47.394230 | 0.697038
47.394058 | 0.696610
47.393978 | 0.696262
47.393913 | 0.695882
47.393879 | 0.695532
47.393898 | 0.695267
47.394009 | 0.694875
47.394115 | 0.694603
47.394180 | 0.694393
47.394165 | 0.694217
47.394199 | 0.694108
47.394321 | 0.693990
47.394367 | 0.693915
47.394402 | 0.693817
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
