bastian-bou/PFE-roule-ma-poule-sans-nid-de-poule/docs/datas/test4_08-02-2019.csv

DATE | LATITUDE | LONGITUDE | ACCELX | ACCELY | ACCELZ | PIEZO
17:34:50 | 47.365112 | 0.685142 | 65529 | 3 | 29 | 0
17:34:50 | 47.365112 | 0.685142 | 65529 | 65531 | 30 | 0
17:34:50 | 47.365112 | 0.685142 | 65533 | 5 | 27 | 0
17:34:50 | 47.365112 | 0.685142 | 65533 | 3 | 31 | 0
17:34:50 | 47.365112 | 0.685142 | 65533 | 6 | 30 | 0
17:34:50 | 47.365112 | 0.685142 | 65532 | 3 | 29 | 0
1:0:1 | 47.365112 | 0.685142 | 65532 | 7 | 32 | 0
1:0:1 | 47.365112 | 0.685142 | 65532 | 8 | 27 | 0
1:0:1 | 47.365112 | 0.685142 | 65530 | 7 | 30 | 0
1:0:1 | 47.365112 | 0.685142 | 65535 | 6 | 30 | 0
1:0:1 | 47.365112 | 0.685142 | 65535 | 7 | 29 | 0
1:0:1 | 47.365112 | 0.685142 | 1 | 7 | 28 | 0
1:0:1 | 47.365112 | 0.685142 | 1 | 3 | 30 | 0
1:0:3 | 47.365112 | 0.685142 | 65531 | 3 | 28 | 0
1:0:3 | 47.365112 | 0.685142 | 65525 | 12 | 29 | 0
1:0:14 | 47.365112 | 0.685142 | 65524 | 1 | 28 | 0
1:0:14 | 47.365112 | 0.685142 | 65530 | 7 | 24 | 0
1:0:14 | 47.365112 | 0.685142 | 65533 | 2 | 29 | 0
1:0:14 | 47.365112 | 0.685142 | 1 | 7 | 31 | 0
1:0:0 | 47.365112 | 0.685142 | 65533 | 1 | 30 | 0
1:0:0 | 47.365112 | 0.685142 | 65534 | 4 | 30 | 0
1:0:0 | 47.365112 | 0.685142 | 3 | 6 | 28 | 0
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
