bastian-bou/PFE-roule-ma-poule-sans-nid-de-poule/Hardware/carte_RouleMaPoule/carte_RouleMaPoule.kicad_pcb

## KiCad design Hardware/carte_RouleMaPoule/carte_RouleMaPoule.kicad_pcb (2019-06-24)

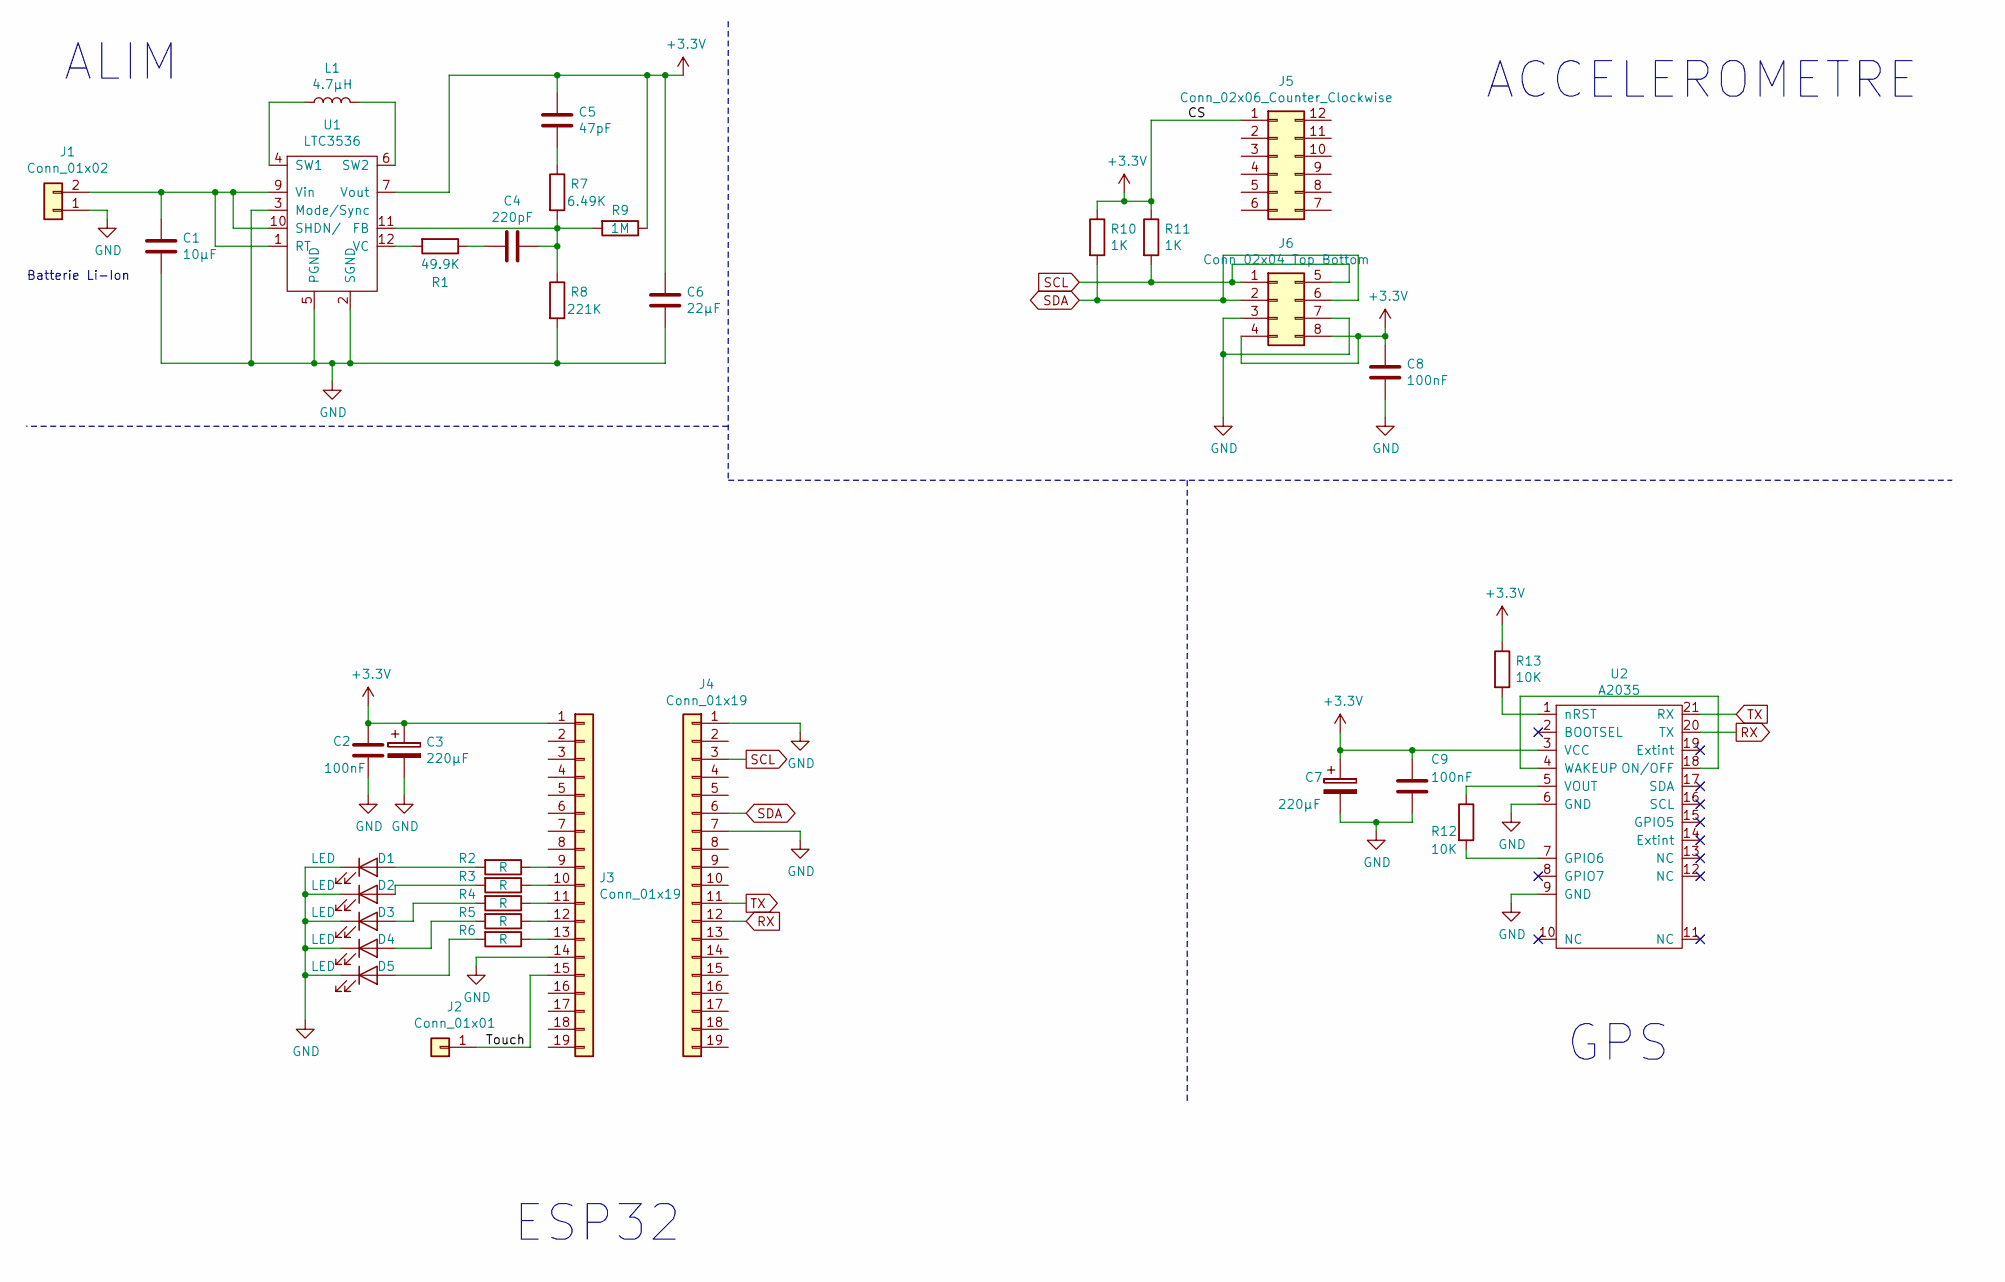
[picture p37: schematic carte_RouleMaPoule.sch]

Parts:
C1: 10µF; C_1206_3216Metric
C2, C8, C9: 100nF; C_1206_3216Metric
C3, C7: 220µF; CP_Elec_6.3x7.7
C4: 220pF; C_1206_3216Metric
C5: 47pF; C_1206_3216Metric
C6: 22µF; C_1206_3216Metric
D1, D2, D3, D4, D5: LED; LED_1210_3225Metric
J1: Conn_01x02; JST_PH_B2B-PH-K_1x02_P2.00mm_Vertical
J2: Conn_01x01; Pin_D0.7mm_L6.5mm_W1.8mm_FlatFork
J3, J4: Conn_01x19; PinHeader_1x19_P2.54mm_Vertical
J5: Conn_02x06_Counter_Clockwise; PinHeader_2x06_P2.54mm_Vertical
J6: Conn_02x04_Top_Bottom; PinHeader_2x04_P2.54mm_Vertical
L1: 4.7µH; L_1210_3225Metric; Farnell 2871486
R1: 49.9K; R_1206_3216Metric
R2, R3, R4, R5, R6: R; R_1206_3216Metric
R7: 6.49K; R_1206_3216Metric
R8: 221K; R_1206_3216Metric
R9: 1M; R_1206_3216Metric
R10, R11: 1K; R_1206_3216Metric
R12, R13: 10K; R_1206_3216Metric
U1: LTC3536; MSOP-12-1EP_3x4mm_P0.65mm_EP1.65x2.85mm
U2: A2035

Connections:
+3V3: C2.1, C3.1, C5.1, C6.1, C7.1, C8.1, C9.1, J3.1, J5.1, J6.4, J6.8, R9.1, R10.1, R11.1, R13.1, U1.7 (Vout), U2.3 (VCC)
/Touch: J2.1, J3.15
GND: C1.2, C2.2, C3.2, C6.2, C7.2, C8.2, C9.2, D1.1 (K), D2.1 (K), D3.1 (K), D4.1 (K), D5.1 (K), J1.1, J3.14, J4.1, J4.7, J6.3, J6.7, R8.2, U1.2 (SGND), U1.3 (Mode/Sync), U1.5 (PGND), U1.13 (PGND), U2.6 (GND), U2.9 (GND)
unnamed: C1.1, J1.2, U1.1 (RT), U1.8 (Vin), U1.9 (Vin), U1.10 (SHDN/)
unnamed: C4.1, R7.2, R8.1, R9.2, U1.11 (FB)
unnamed: C4.2, R1.1
unnamed: C5.2, R7.1
unnamed: D1.2 (A), R2.2
unnamed: D2.2 (A), R3.2
unnamed: D3.2 (A), R4.2
unnamed: D4.2 (A), R5.2
unnamed: D5.2 (A), R6.2
unnamed: J3.9, R2.1
unnamed: J3.10, R3.1
unnamed: J3.11, R4.1
unnamed: J3.12, R5.1
unnamed: J3.13, R6.1
unnamed: L1.1, U1.4 (SW1)
unnamed: L1.2, U1.6 (SW2)
unnamed: R1.2, U1.12 (VC)
unnamed: R12.1, U2.5 (VOUT)
unnamed: R12.2, U2.7 (GPIO6)
unnamed: R13.2, U2.1 (nRST)
unnamed: U2.4 (WAKEUP), U2.18 (ON/OFF)
RX: J4.12, U2.20 (TX)
SCL: J4.3, J6.1, J6.5, R11.2
SDA: J4.6, J6.2, J6.6, R10.2
TX: J4.11, U2.21 (RX)

Notes on the sheet:
ESP32
GPS
ACCELEROMETRE
ALIM
Batterie Li-Ion

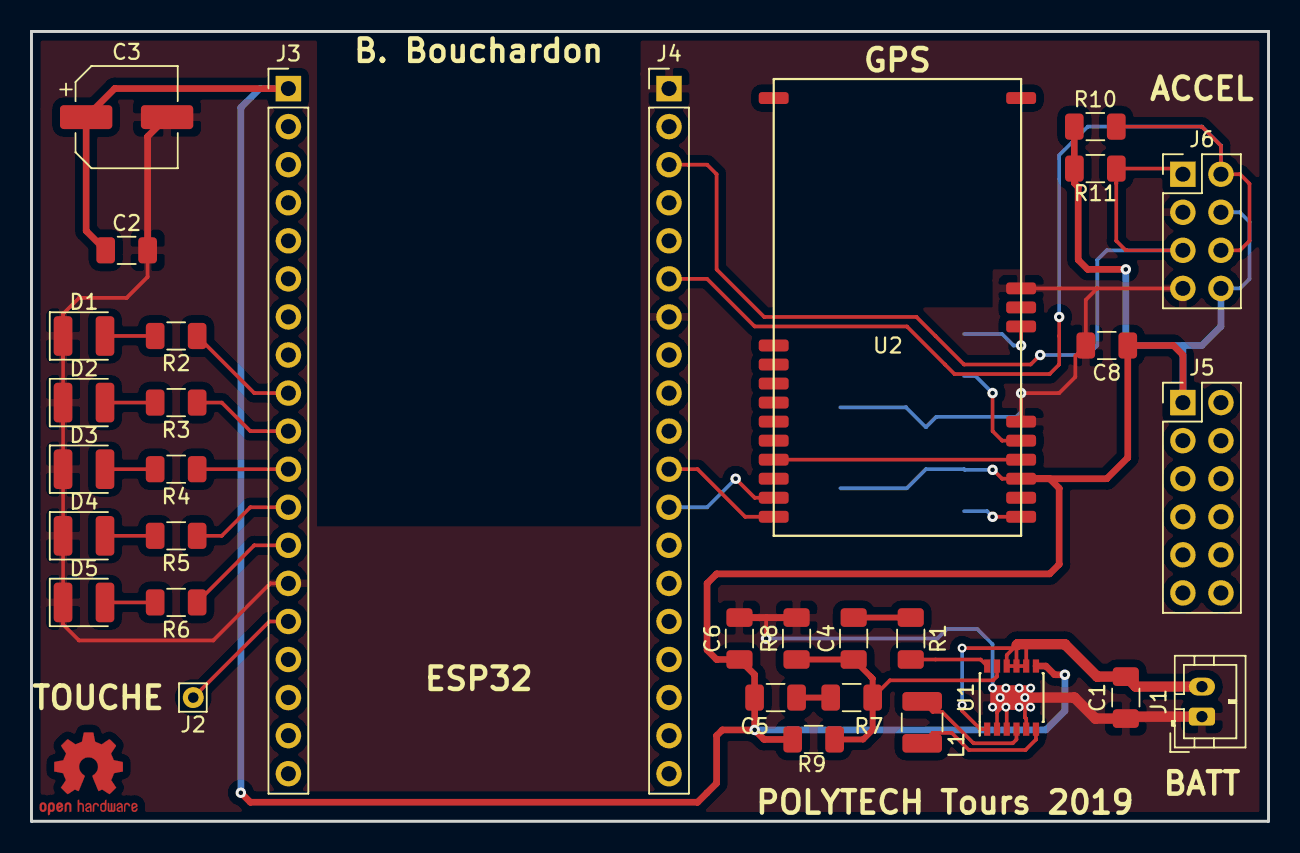
[picture p38: board carte_RouleMaPoule.kicad_pcb from above]

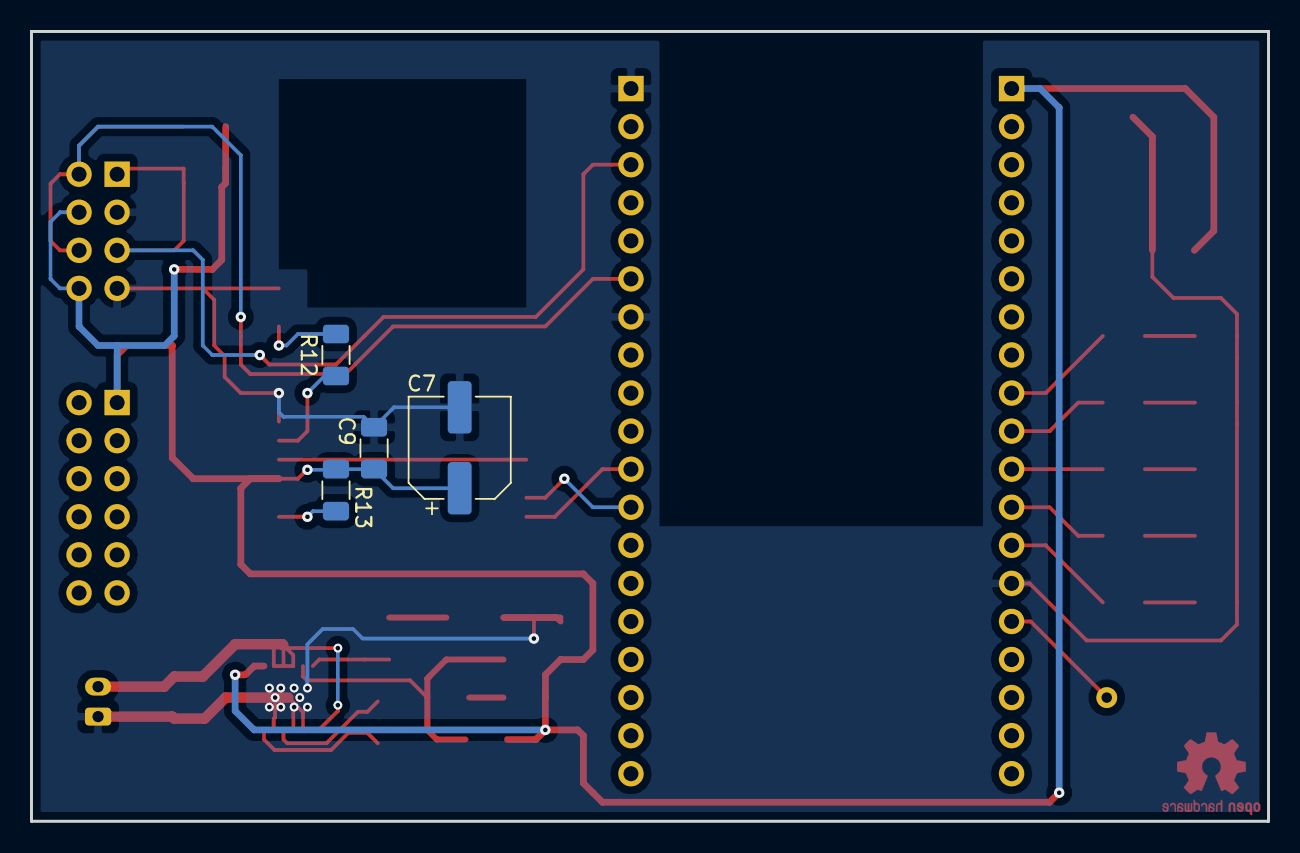
[picture p39: board carte_RouleMaPoule.kicad_pcb from below]

Board: 2 copper layers, 82.5 x 52.7 mm, 36 parts (4 on the bottom side), 28 nets.
